0xDBFB7/ceramic/README.md

See https://0xdbfb7.com/furnace.html.

<3
