0xDBFB7/ceramic/documents/supplies.md

Calcined Alumina, obtained from Tucker's Pottery $12/kg.

Emerson 767A-372 Hot Surface Ignitor, amazon.ca

Amaco 28035N Insulating FireBrick, 9" x 4-1/2" x 2-1/2" Size

Stoner thermoplastic mold release, McMaster-Carr #1409K44
