0xDBFB7/ceramic/documents/process_2.md

1. Mix solution of 3% gelatine into water at 40-50c. 60c?
2. Stir in an equal volume of Alumina.
3. Vacuum degas at 10mmHg for 3 minutes. Stir slightly.
4. Apply mold release to mold. Wait a few minutes for it to dry. Flexible molds preferred.
5. Pour into mold.
6. Bake at 70c for at least 2 hours.
7. Remove from mold.
8. Sinter to 600c at 1c/min.
9. Sinter as hot as your kiln can manage (over 1300c is best) at 2c/min.
