0xDBFB7/ceramic/documents/images/furnace/CIMG6680.JPG

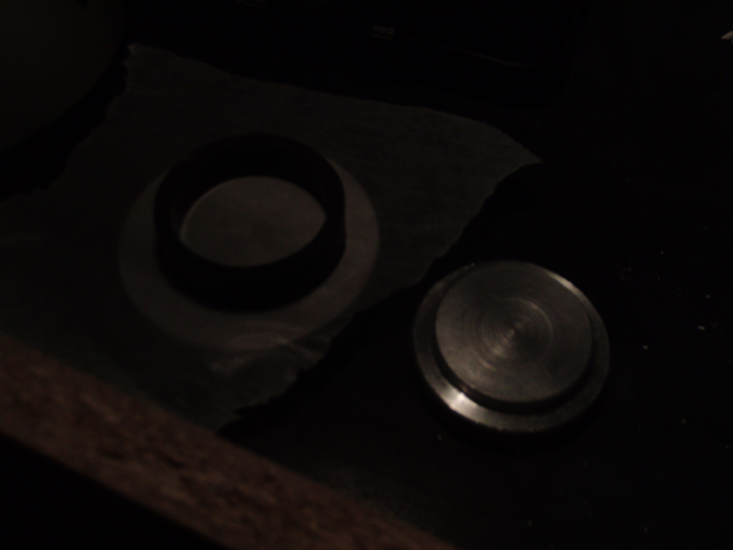
documents/images/furnace/CIMG6680.JPG
