0xDBFB7/ceramic/files/mli_wax_mold.FCStd

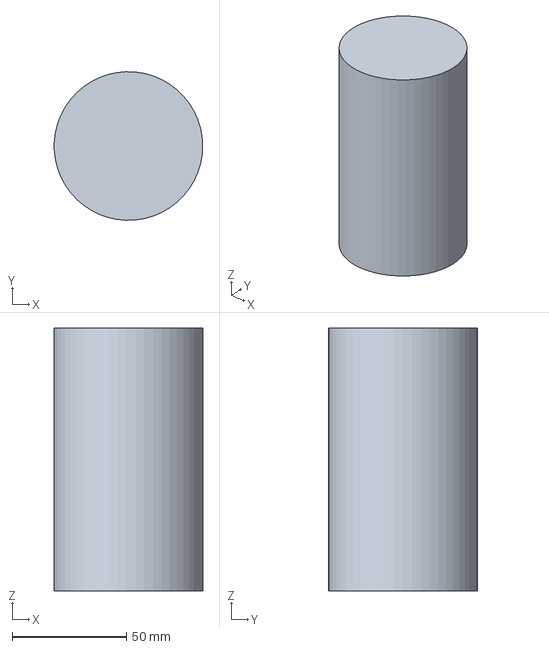
[picture p13: CAD file, 2020-03-07]
files/mli_wax_mold.FCStd
64.9 x 65.0 x 115.0 mm
