0xDBFB7/ceramic/files/coupon_style_7.fcstd

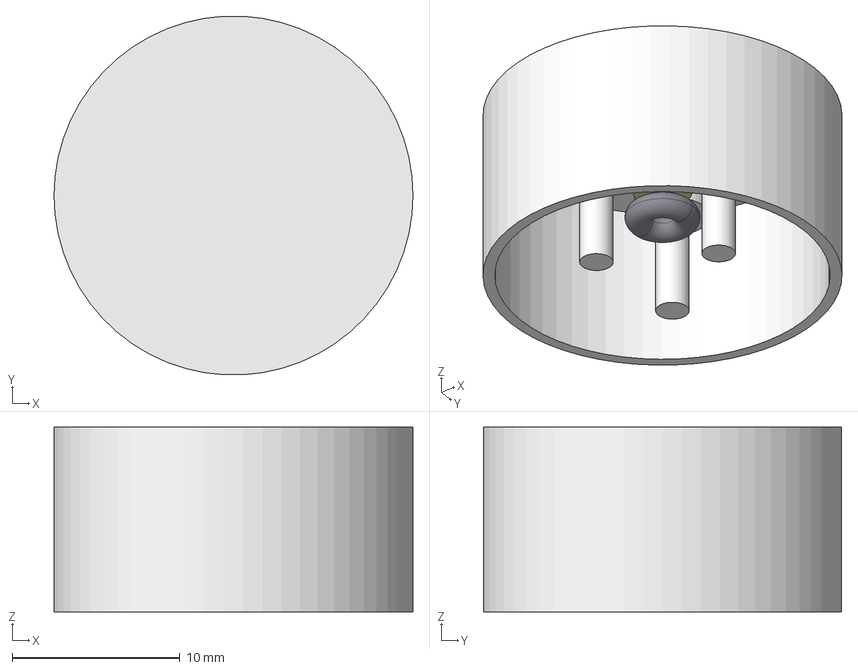
[picture p14: CAD file, 2019-03-01]
files/coupon_style_7.fcstd
21.4 x 21.4 x 11.0 mm
TopOring
BottomOring
