0xDBFB7/ceramic/files/test_parts/torus.fcstd

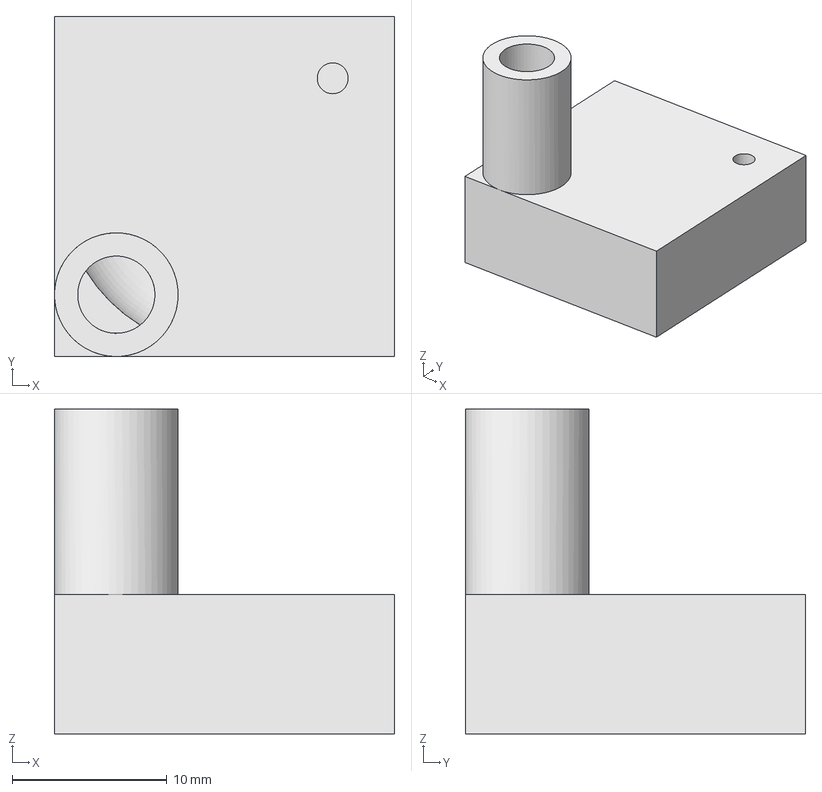
[picture p15: CAD file, 2019-02-09]
files/test_parts/torus.fcstd
22.0 x 22.0 x 21.0 mm
