0xDBFB7/ceramic/files/test_parts/insert_bottom.fcstd

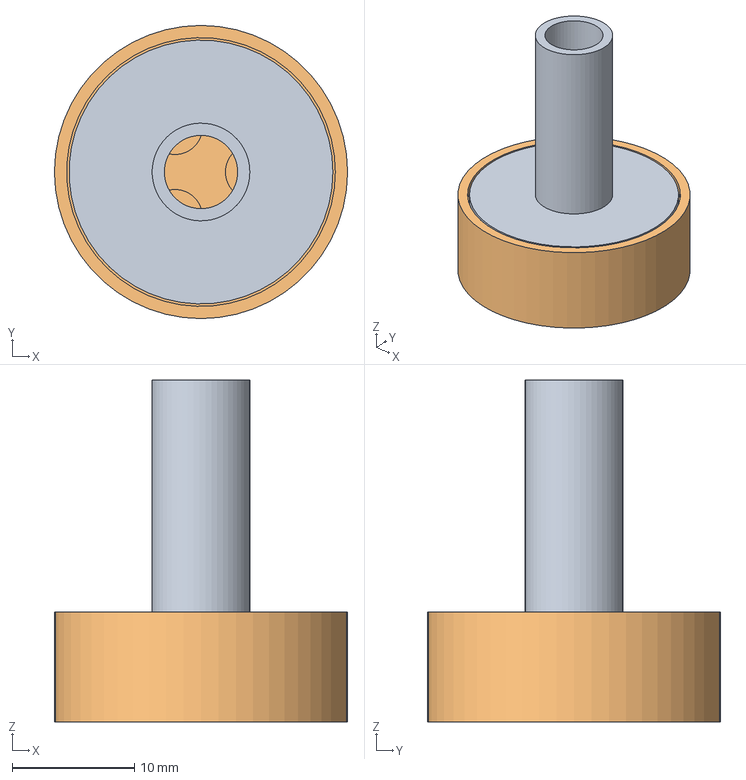
[picture p16: CAD file, 2019-02-09]
files/test_parts/insert_bottom.fcstd
24.0 x 24.0 x 28.0 mm
