0xDBFB7/ceramic/files/test_parts/insert.fcstd

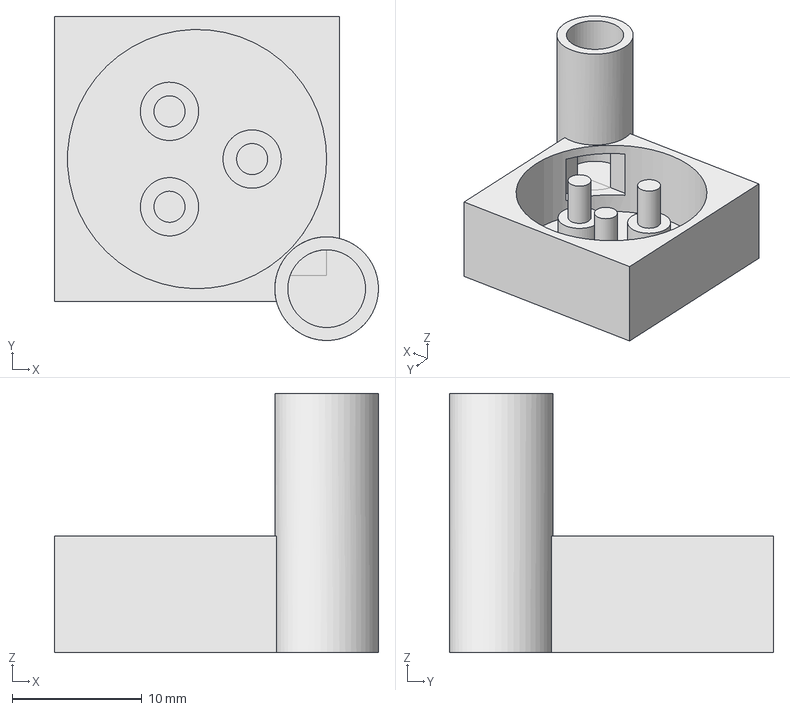
[picture p17: CAD file, 2019-02-09]
files/test_parts/insert.fcstd
25.0 x 25.0 x 20.0 mm
