0xDBFB7/ceramic/files/test_parts/insert_lid.stl

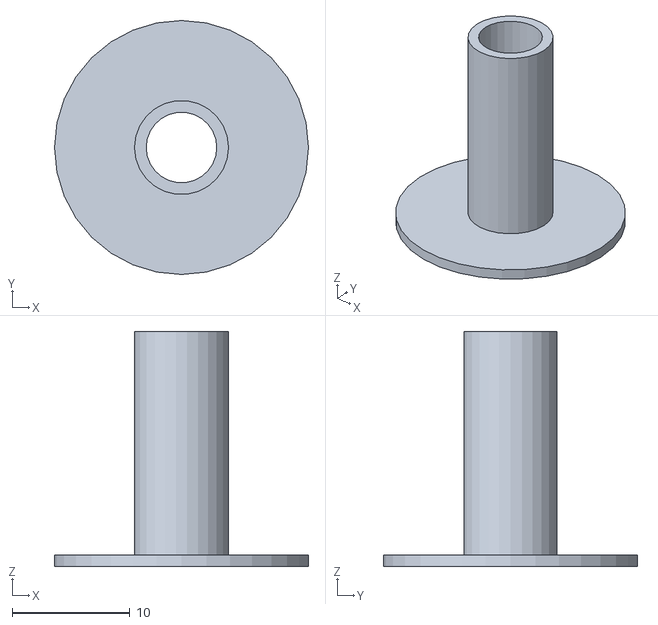
[picture p18: CAD file, 2019-02-09]
files/test_parts/insert_lid.stl
21.6 x 21.6 x 20.0
