0xDBFB7/ceramic/files/test_parts/insert_closed.stl

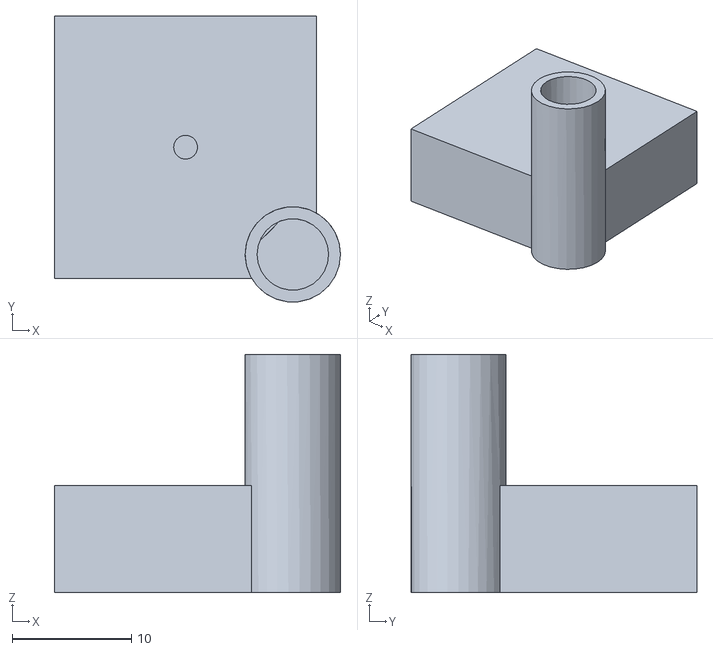
[picture p19: CAD file, 2019-02-09]
files/test_parts/insert_closed.stl
24.0 x 24.0 x 20.0
