0xDBFB7/ceramic/(list of files, cad)

Other CAD files:
files/test_parts/star.fcstd
files/test_parts/torus_big.stl
files/test_parts/insert_bottom.stl
files/test_parts/torus.stl
