0xDBFB7/ceramic/documents/images/furnace/NFPA-704-NFPA-Diamonds-Sign-NFPA_PRINTED_4230_1000.gif

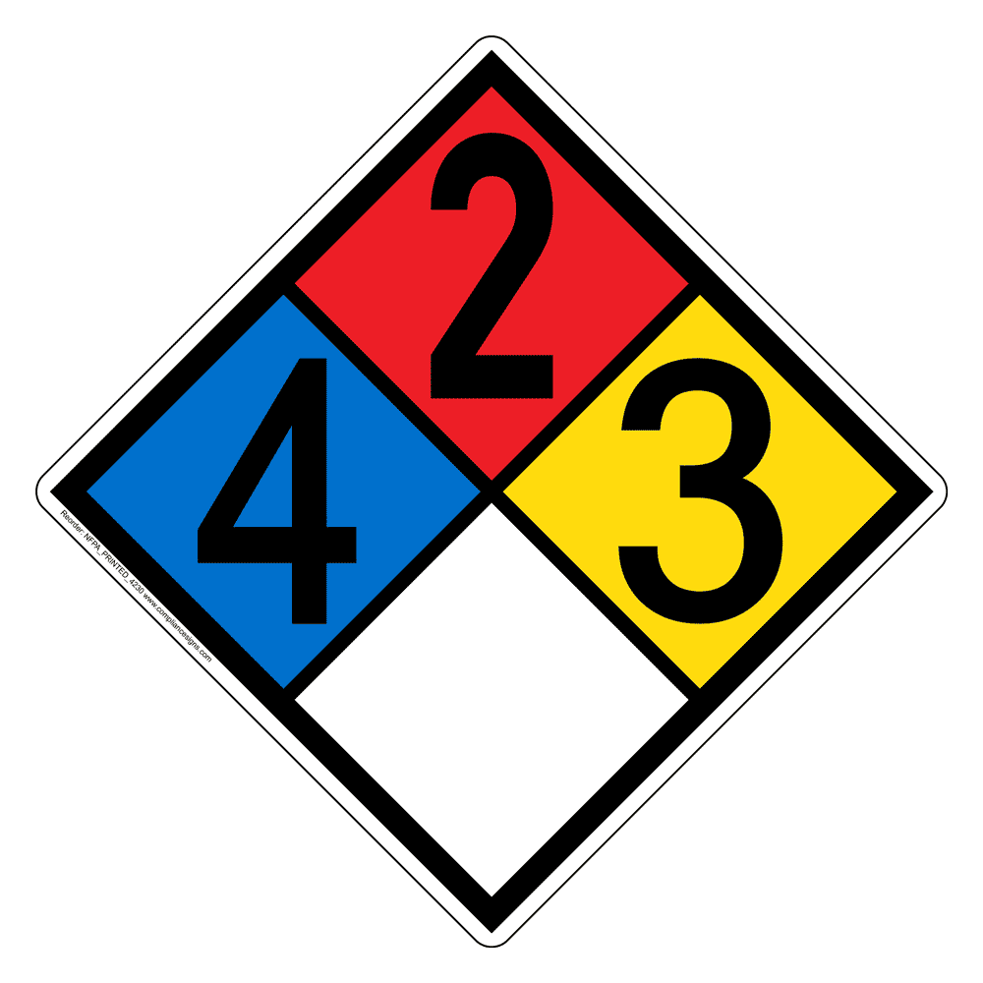
documents/images/furnace/NFPA-704-NFPA-Diamonds-Sign-NFPA_PRINTED_4230_1000.gif
