0xDBFB7/ceramic/(commit log)

2019-03-01 Reworking recipe
    [coupon_style_7.fcstd]
2019-03-30 switching to scientific third-person
2020-03-07 Forgot what's been changed
    [mli_wax_mold.FCStd]
